atelier-lyon/Epiled_slaves/Small/README.md

# Small Board
## By Florian "FloRide" Reimat

## About
This is the Small board

## Images:
### [Schematic](Export/Schematics.pdf):


### [PCB](Export/PCB.pdf):
| Front | Bottom |
:------:|:-------:
|| |

### 3D:
| Simple | Detailled |
:------:|:-------:
|| |

## Others:
- [Interactive BOM](Export/ibom/ibom.html) (Download it and use it)
