atelier-lyon/Epiled_slaves/Small_Wall/Export/Schematic.pdf

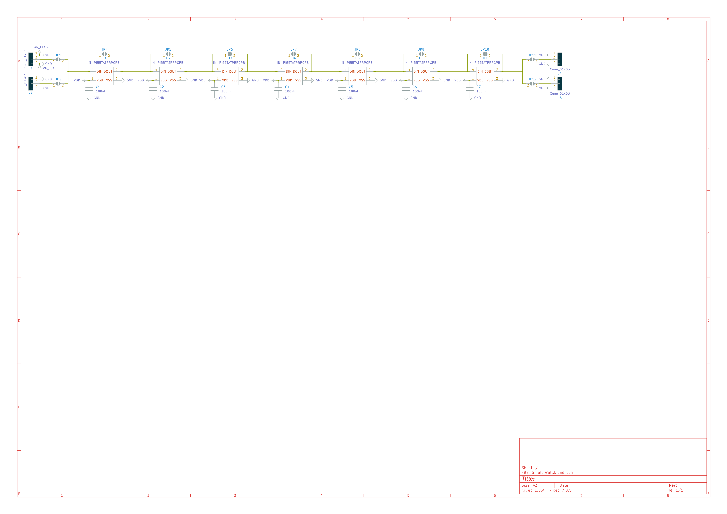
[picture p1: page 1]
