atelier-lyon/Epiled_slaves/Small_Wall/View/small_wall_v1.0.step

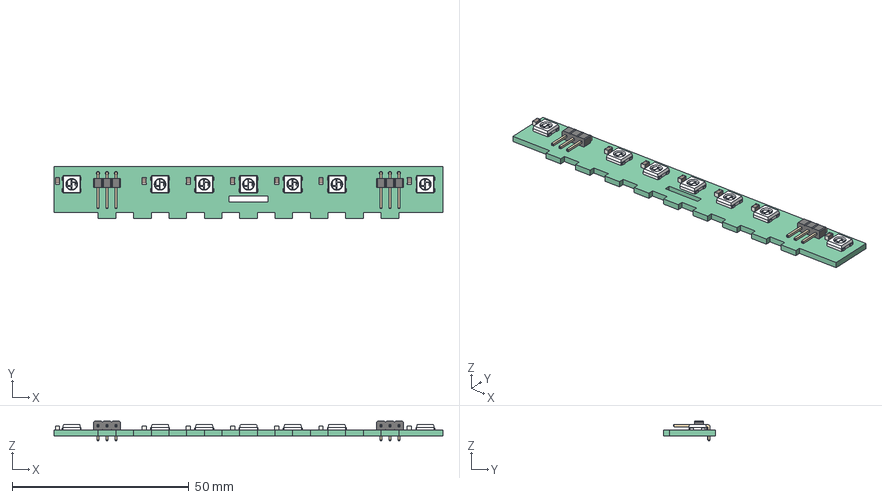
[picture p2: CAD file, 2023-07-18]
Small_Wall/View/small_wall_v1.0.step
110.0 x 14.6 x 5.54 mm
Local_CS_955f
Pcb_955f
J1_PinHeader_1x03_P254mm_Horizontal_86b41215f255
C6_C_0805_2012Metric_c65d50394145
U2_IN-PI55TATPRPGPB_b85f727c27e0
C4_C_0805_2012Metric_1086d08a19b9
U5_IN-PI55TATPRPGPB_a745e96a4803
U6_IN-PI55TATPRPGPB_b1dd87a4917c
C2_C_0805_2012Metric_acea1357e9b1
C7_C_0805_2012Metric_d1ab99c13446
C3_C_0805_2012Metric_30713c1e22a0
U1_IN-PI55TATPRPGPB_baa3a1cbfda9
J4_PinHeader_1x03_P254mm_Horizontal_40c13ec2b1c1
U4_IN-PI55TATPRPGPB_b795d5d795ae
U3_IN-PI55TATPRPGPB_56d7a105f291
U7_IN-PI55TATPRPGPB_ceba1dbc2faf
C1_C_0805_2012Metric_a1f97324ab0b
C5_C_0805_2012Metric_711e44d1b90e
