atelier-lyon/Epiled_slaves/(list of files, cad)

Other CAD files:
Small/DXF/Small-B_Silkscreen.dxf
Small/DXF/Small-F_Silkscreen.dxf
Small_Wall/DXF/Small_Wall-B_Silkscreen.dxf
Small_Wall/DXF/Small_Wall-F_Silkscreen.dxf
