atelier-lyon/Epiled_slaves/Small/Export/Schematic.pdf

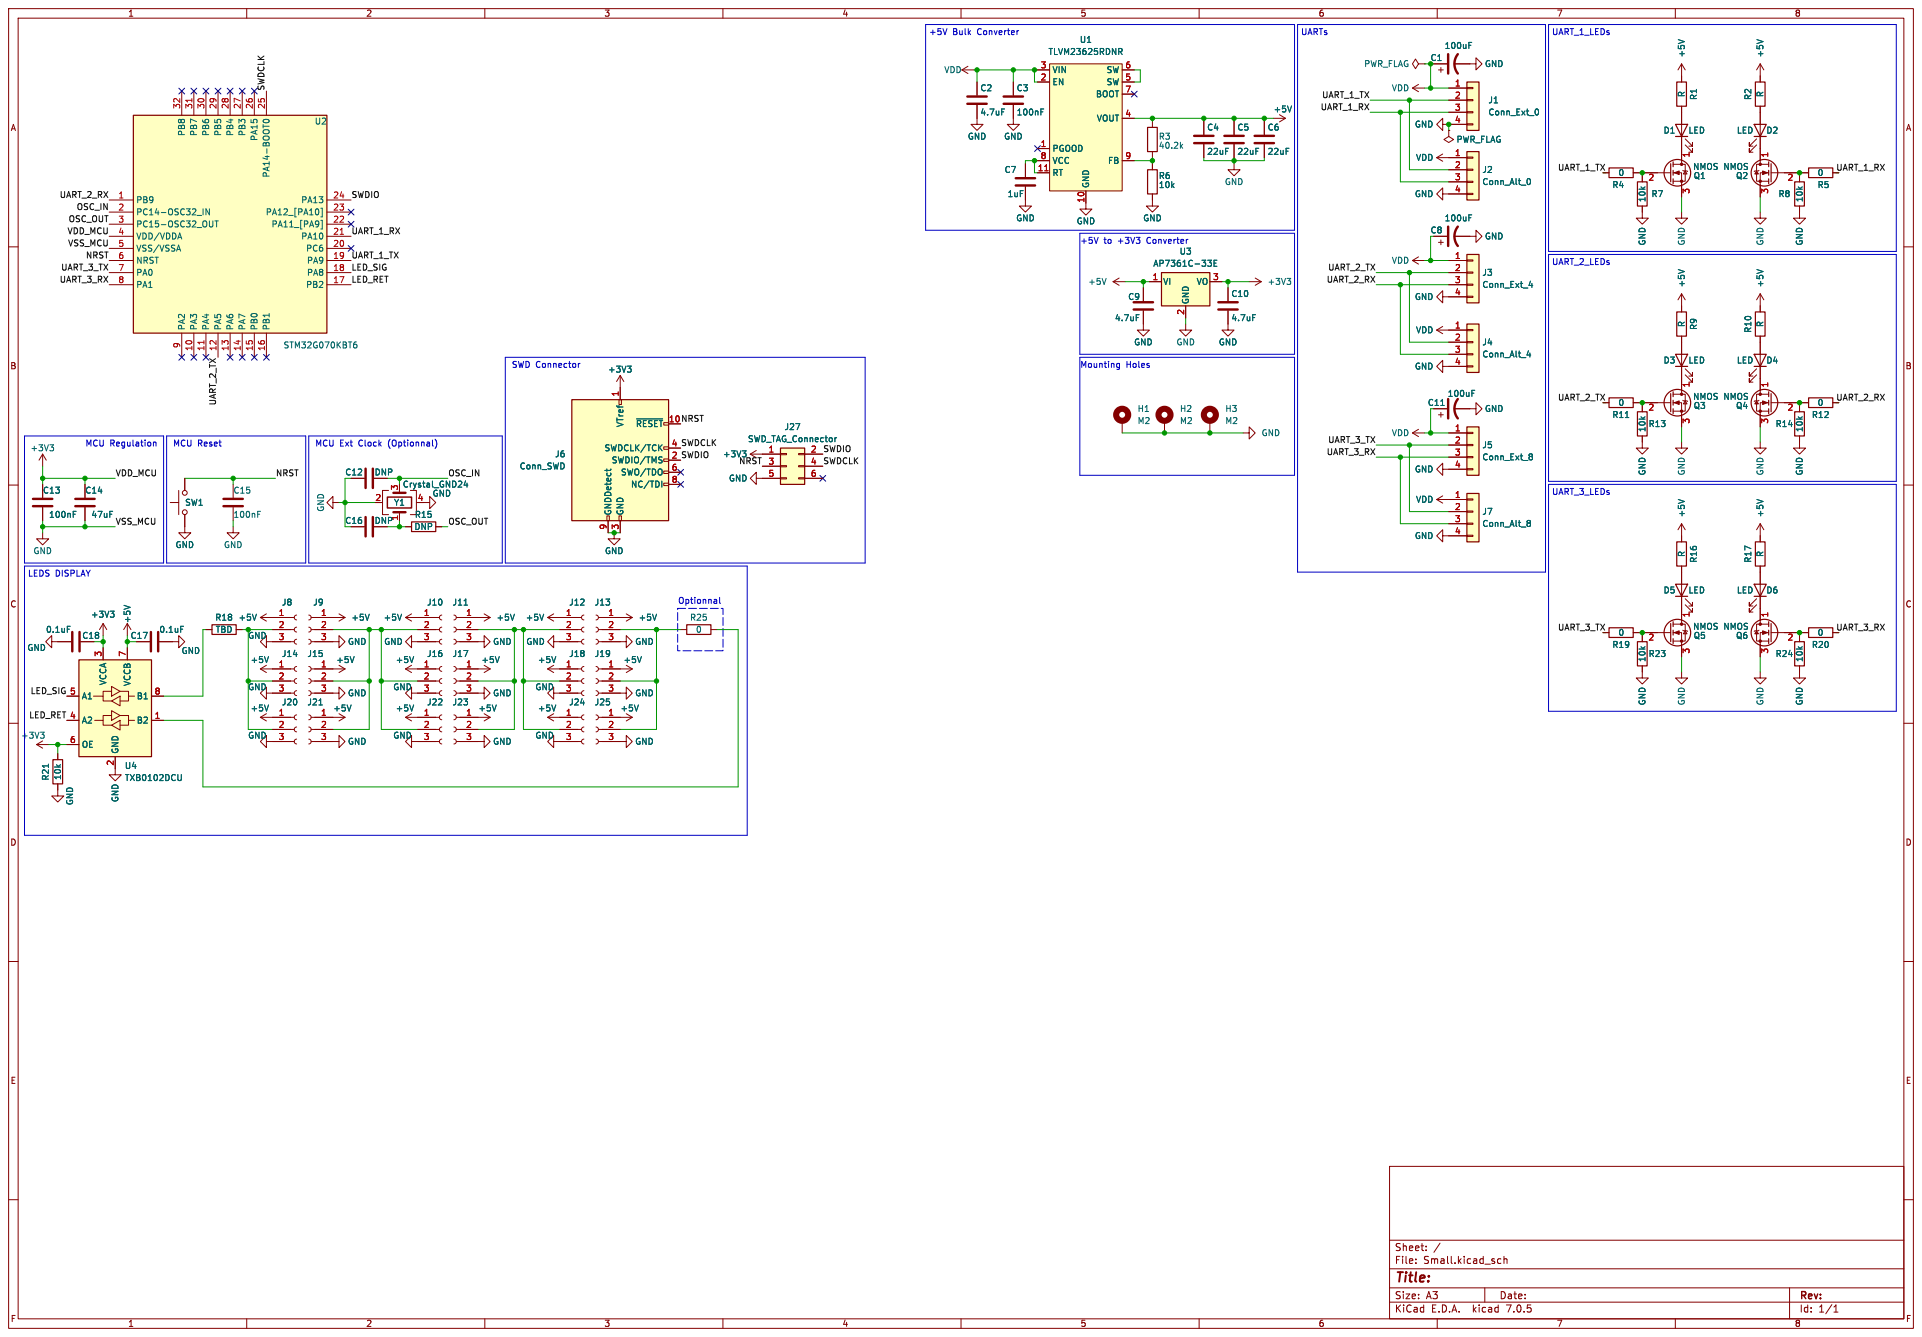
[picture p3: page 1]

3 SWDCLK/TCK 4 SWO/TDO 6 NC/TDI 8 GNDDetect 9 +3V3 GND GND

3 SWDCLK/TCK 4 SWO/TDO 6 NC/TDI 8 GNDDetect 9

Id: 1/1 Title: File: Small.kicad_sch Sheet: /
