atelier-lyon/Epiled_slaves/Small_Wall/Export/PCB.pdf

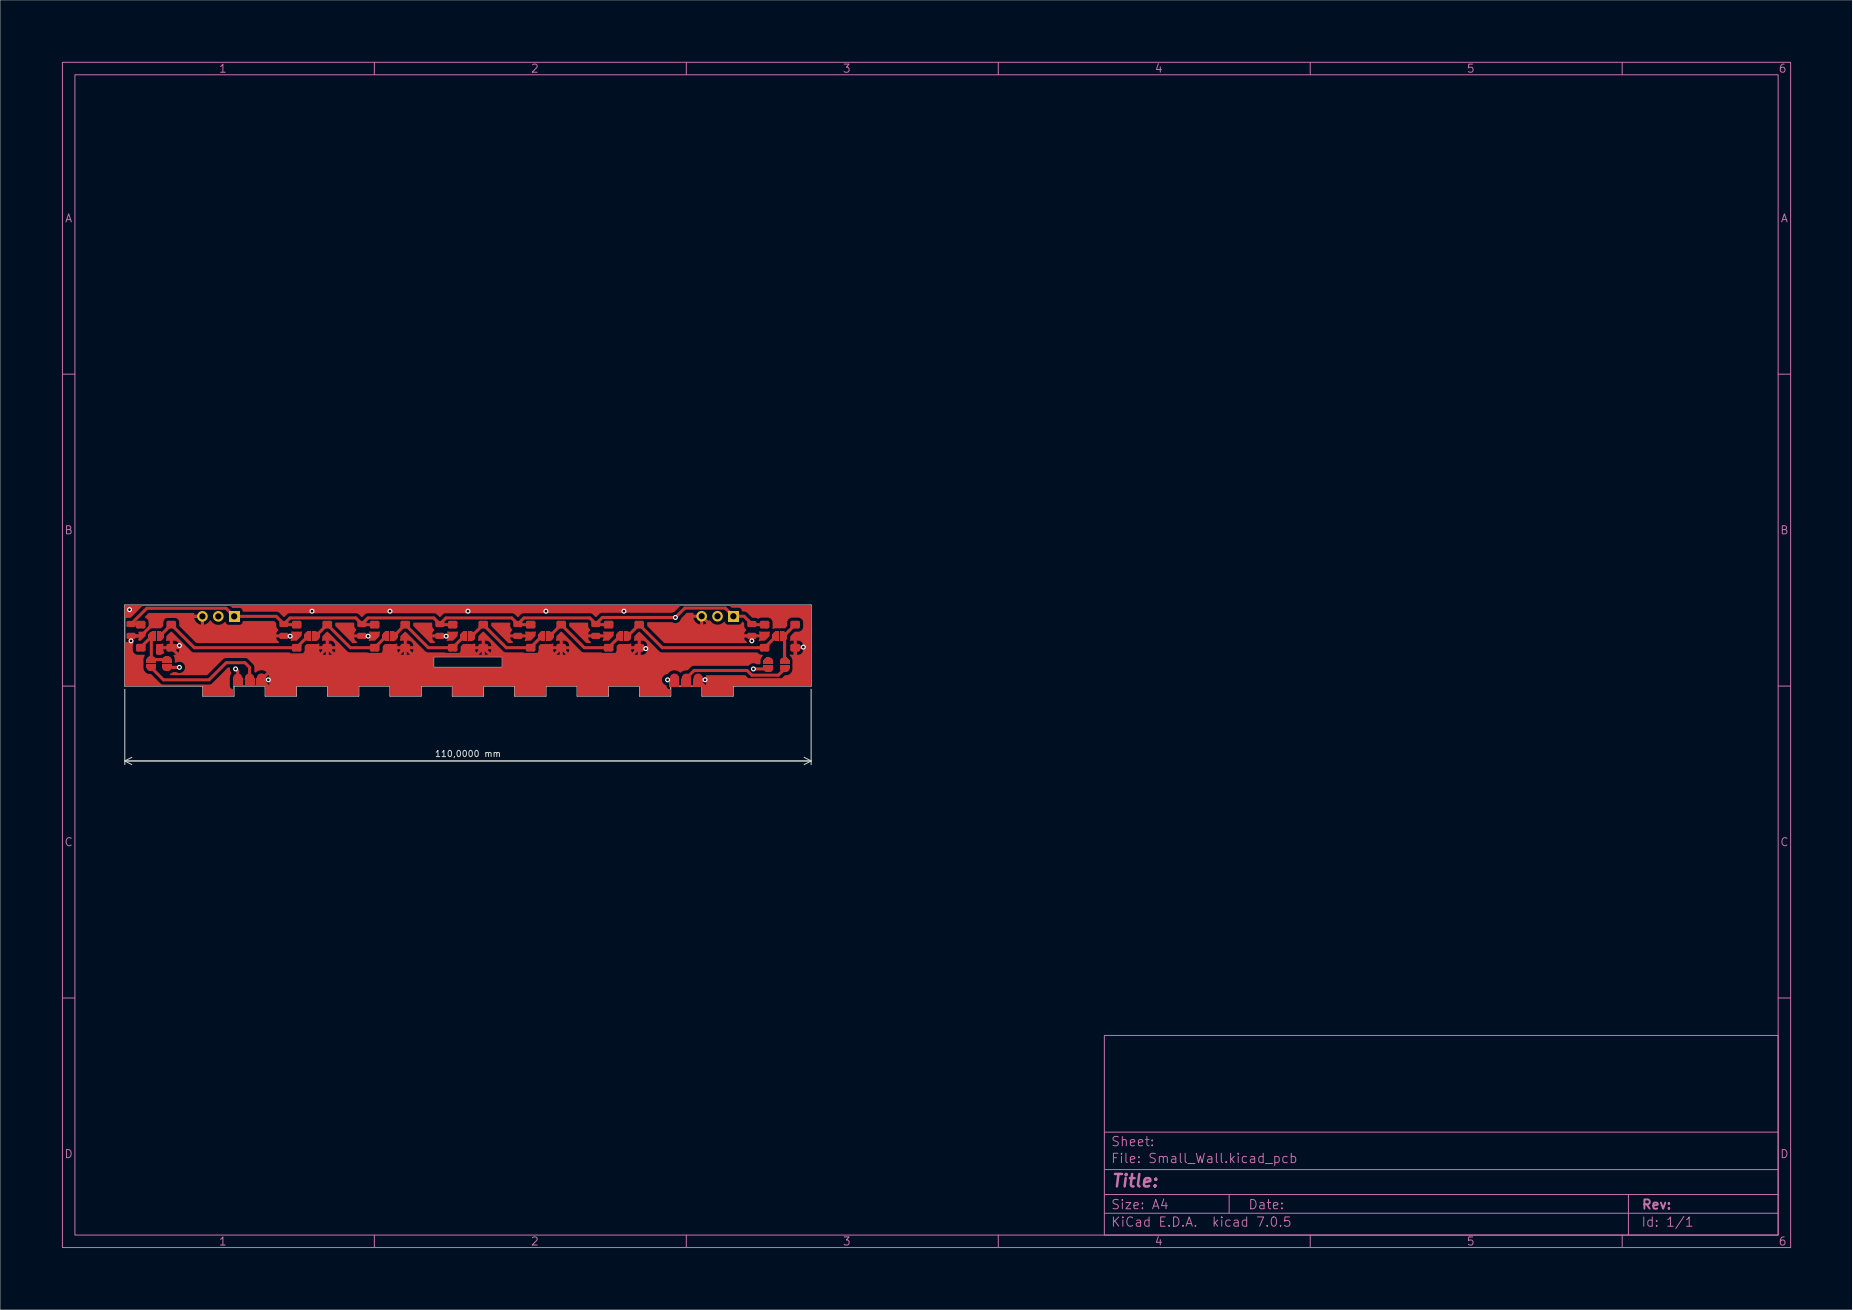
[picture p4: page 1]

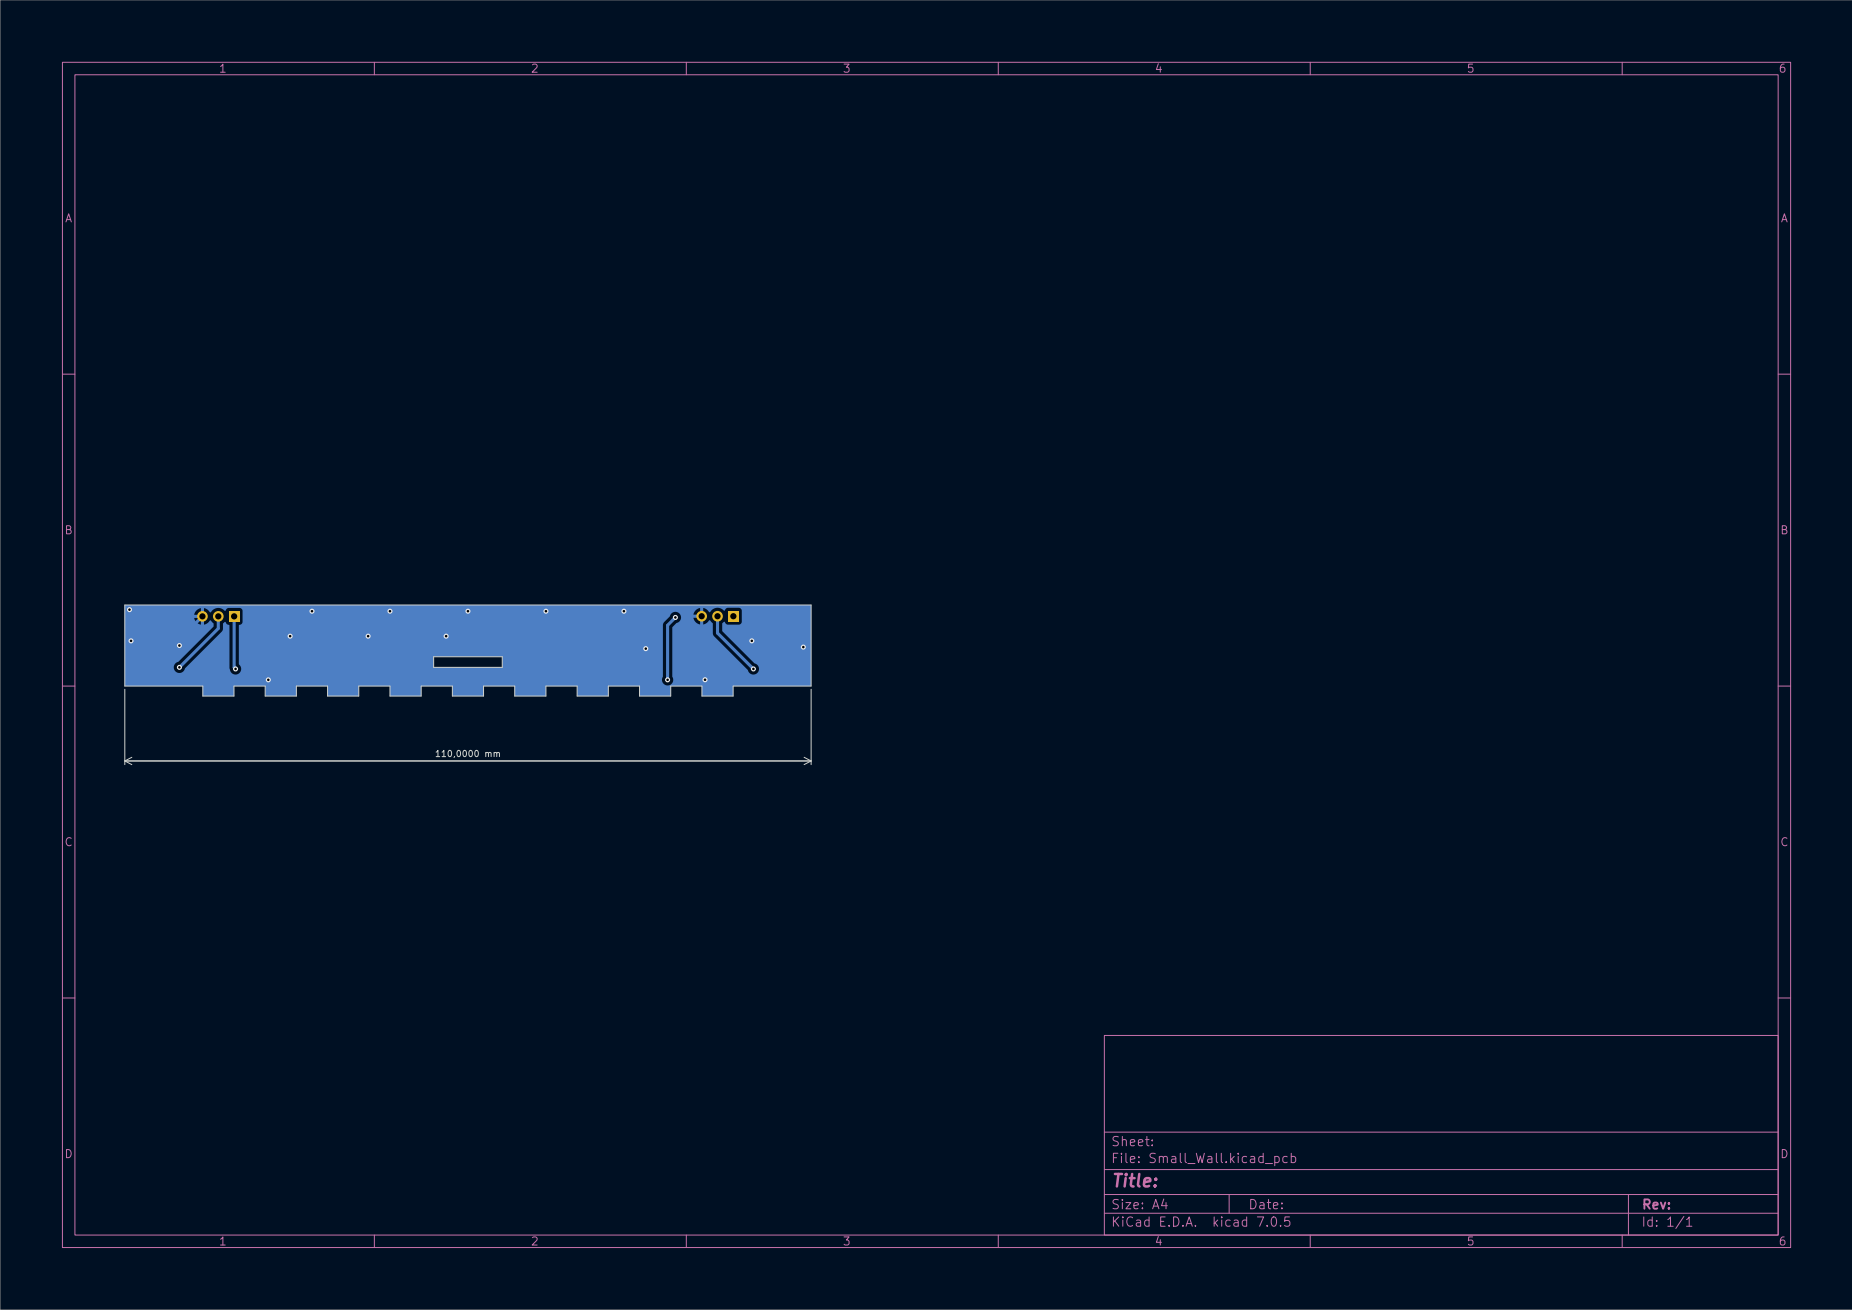
[picture p5: page 2]

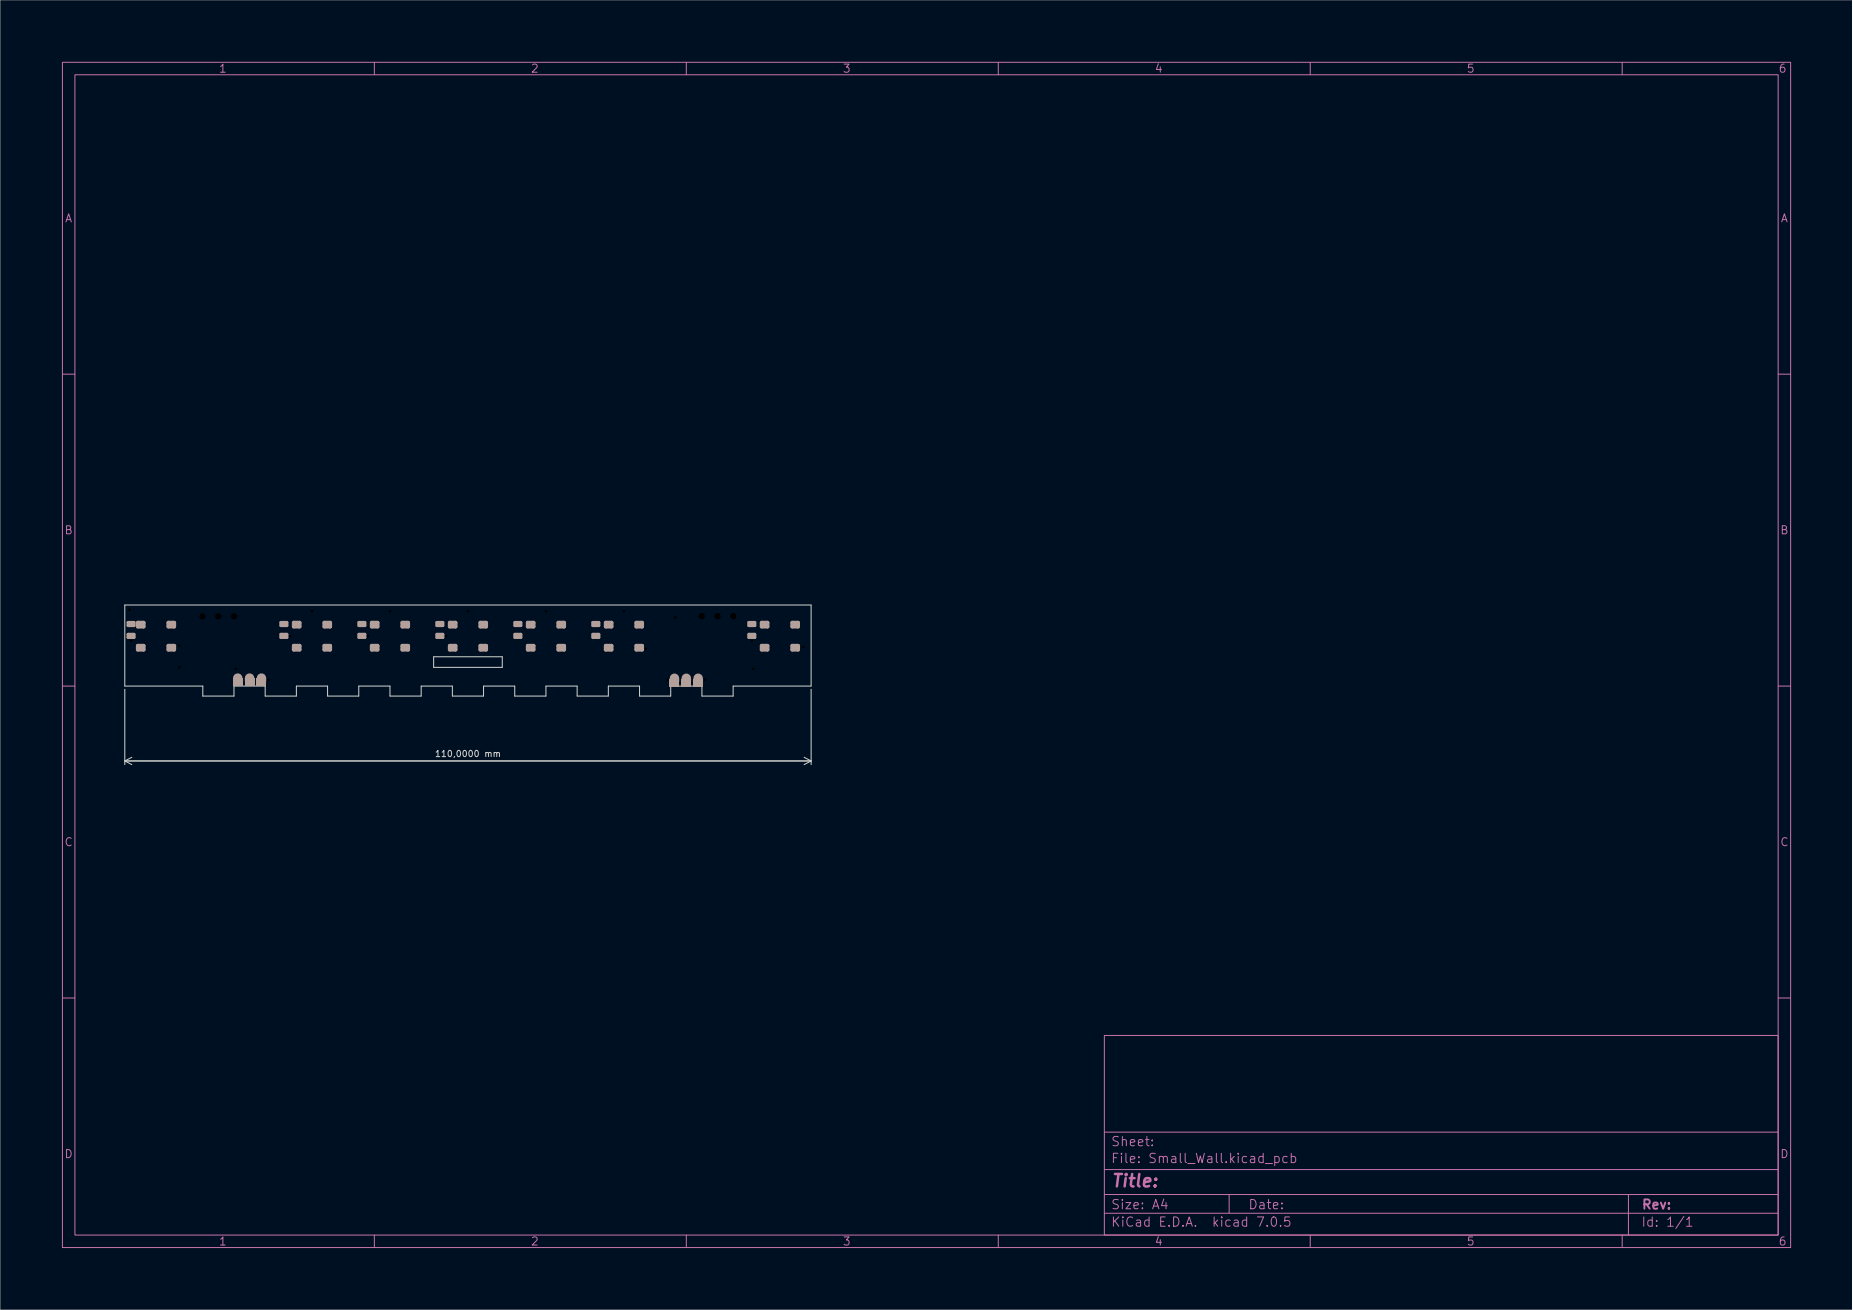
[picture p6: page 3]

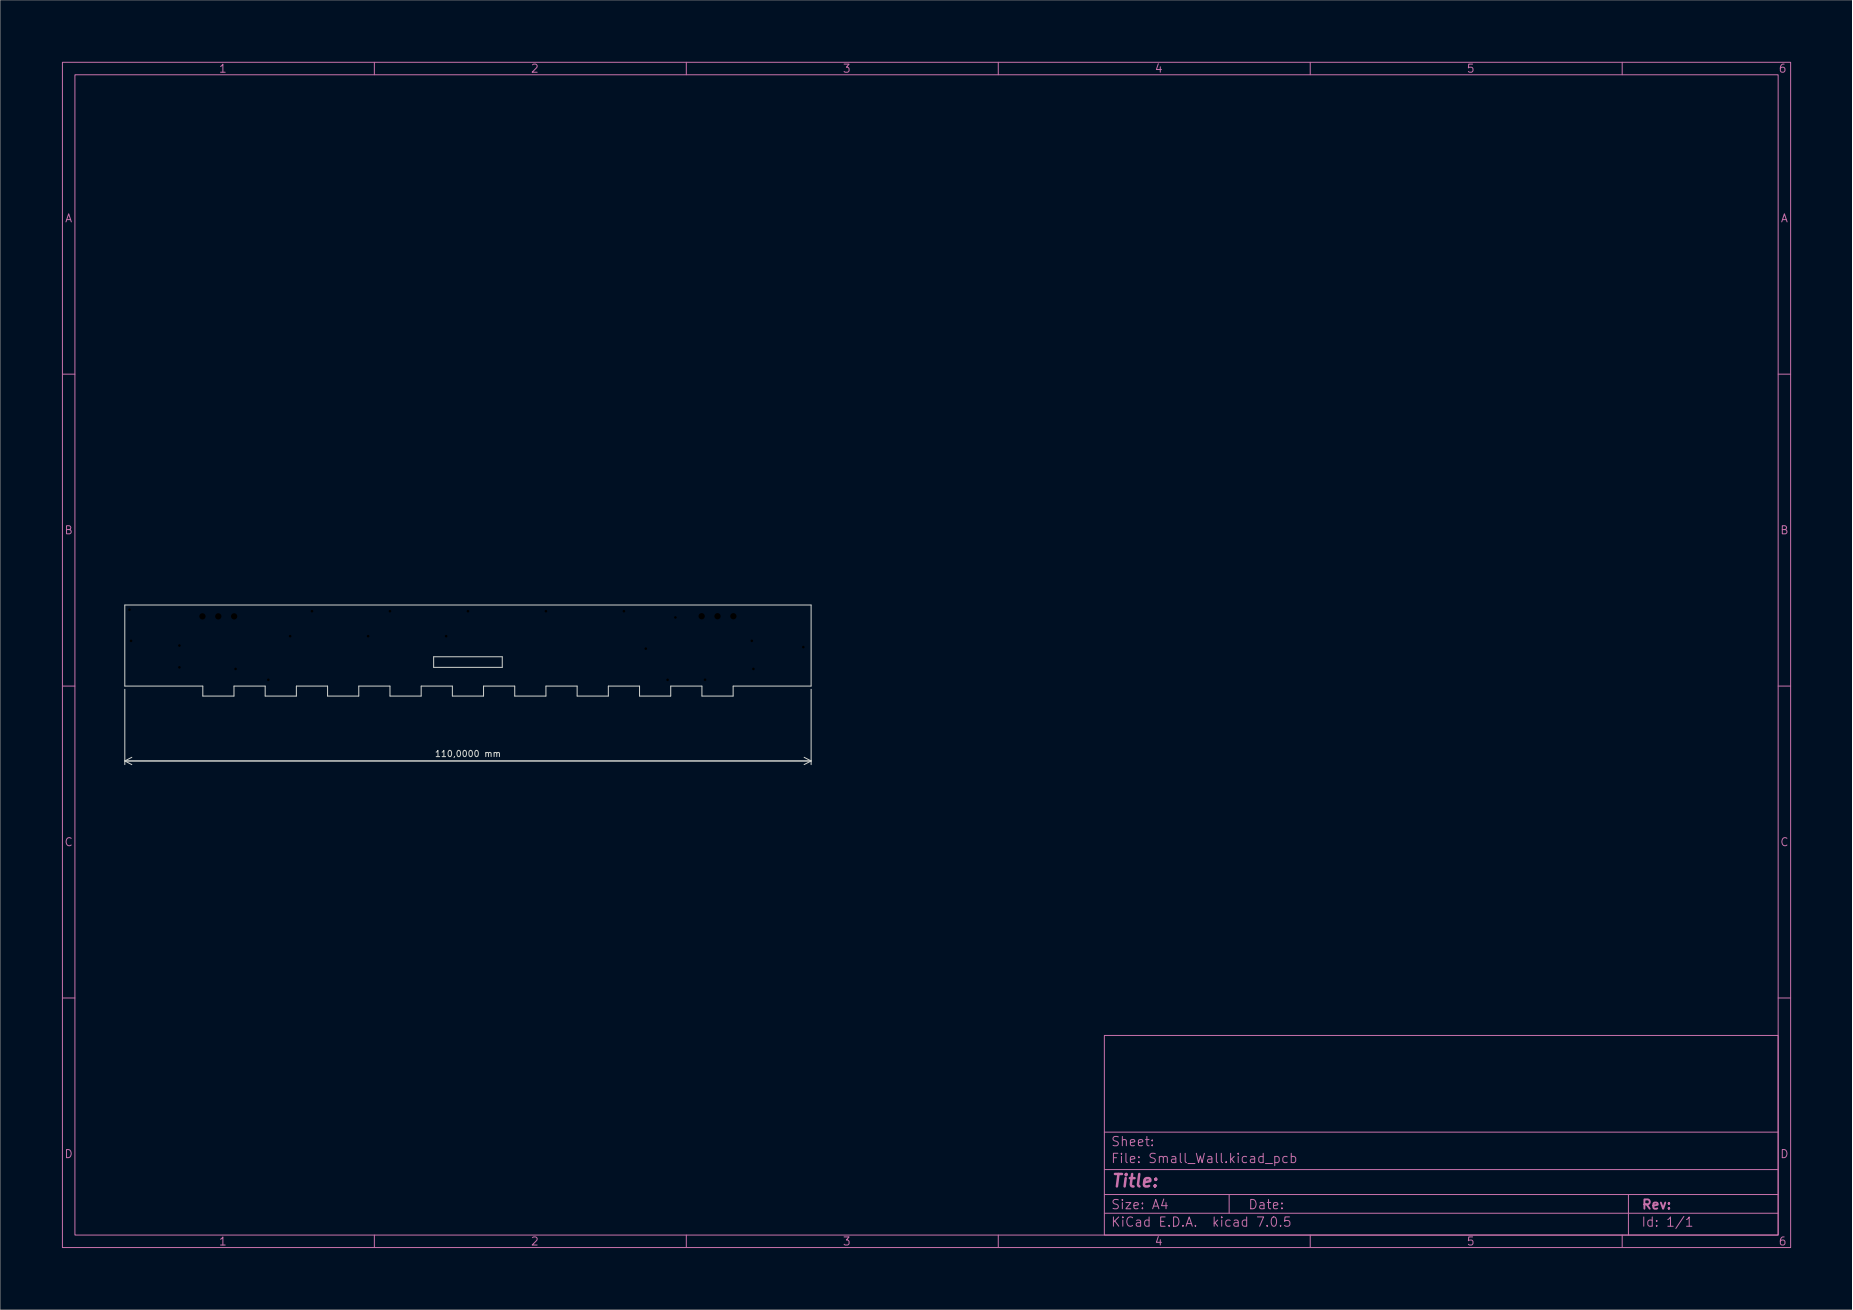
[picture p7: page 4]

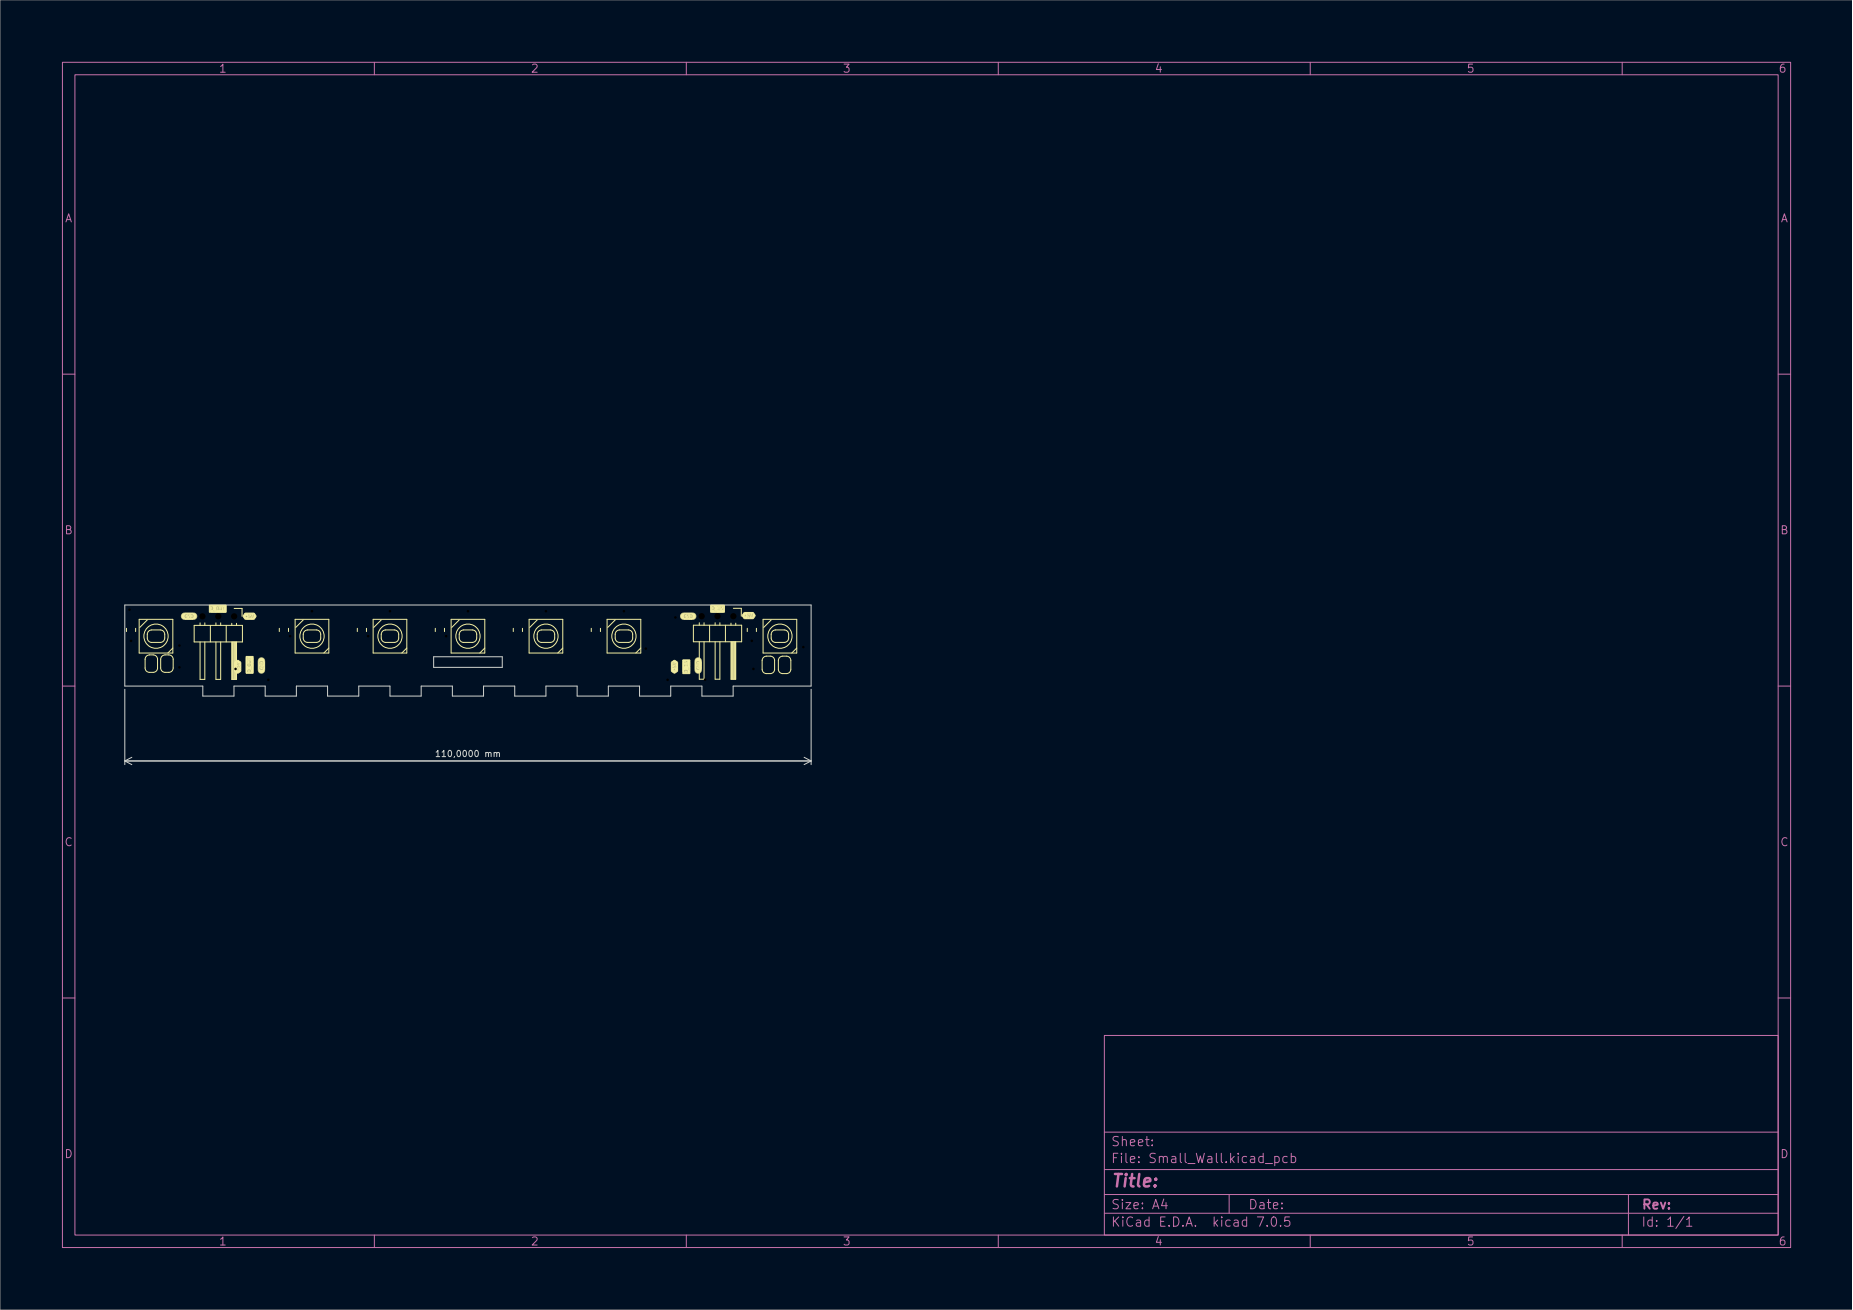
[picture p8: page 5]

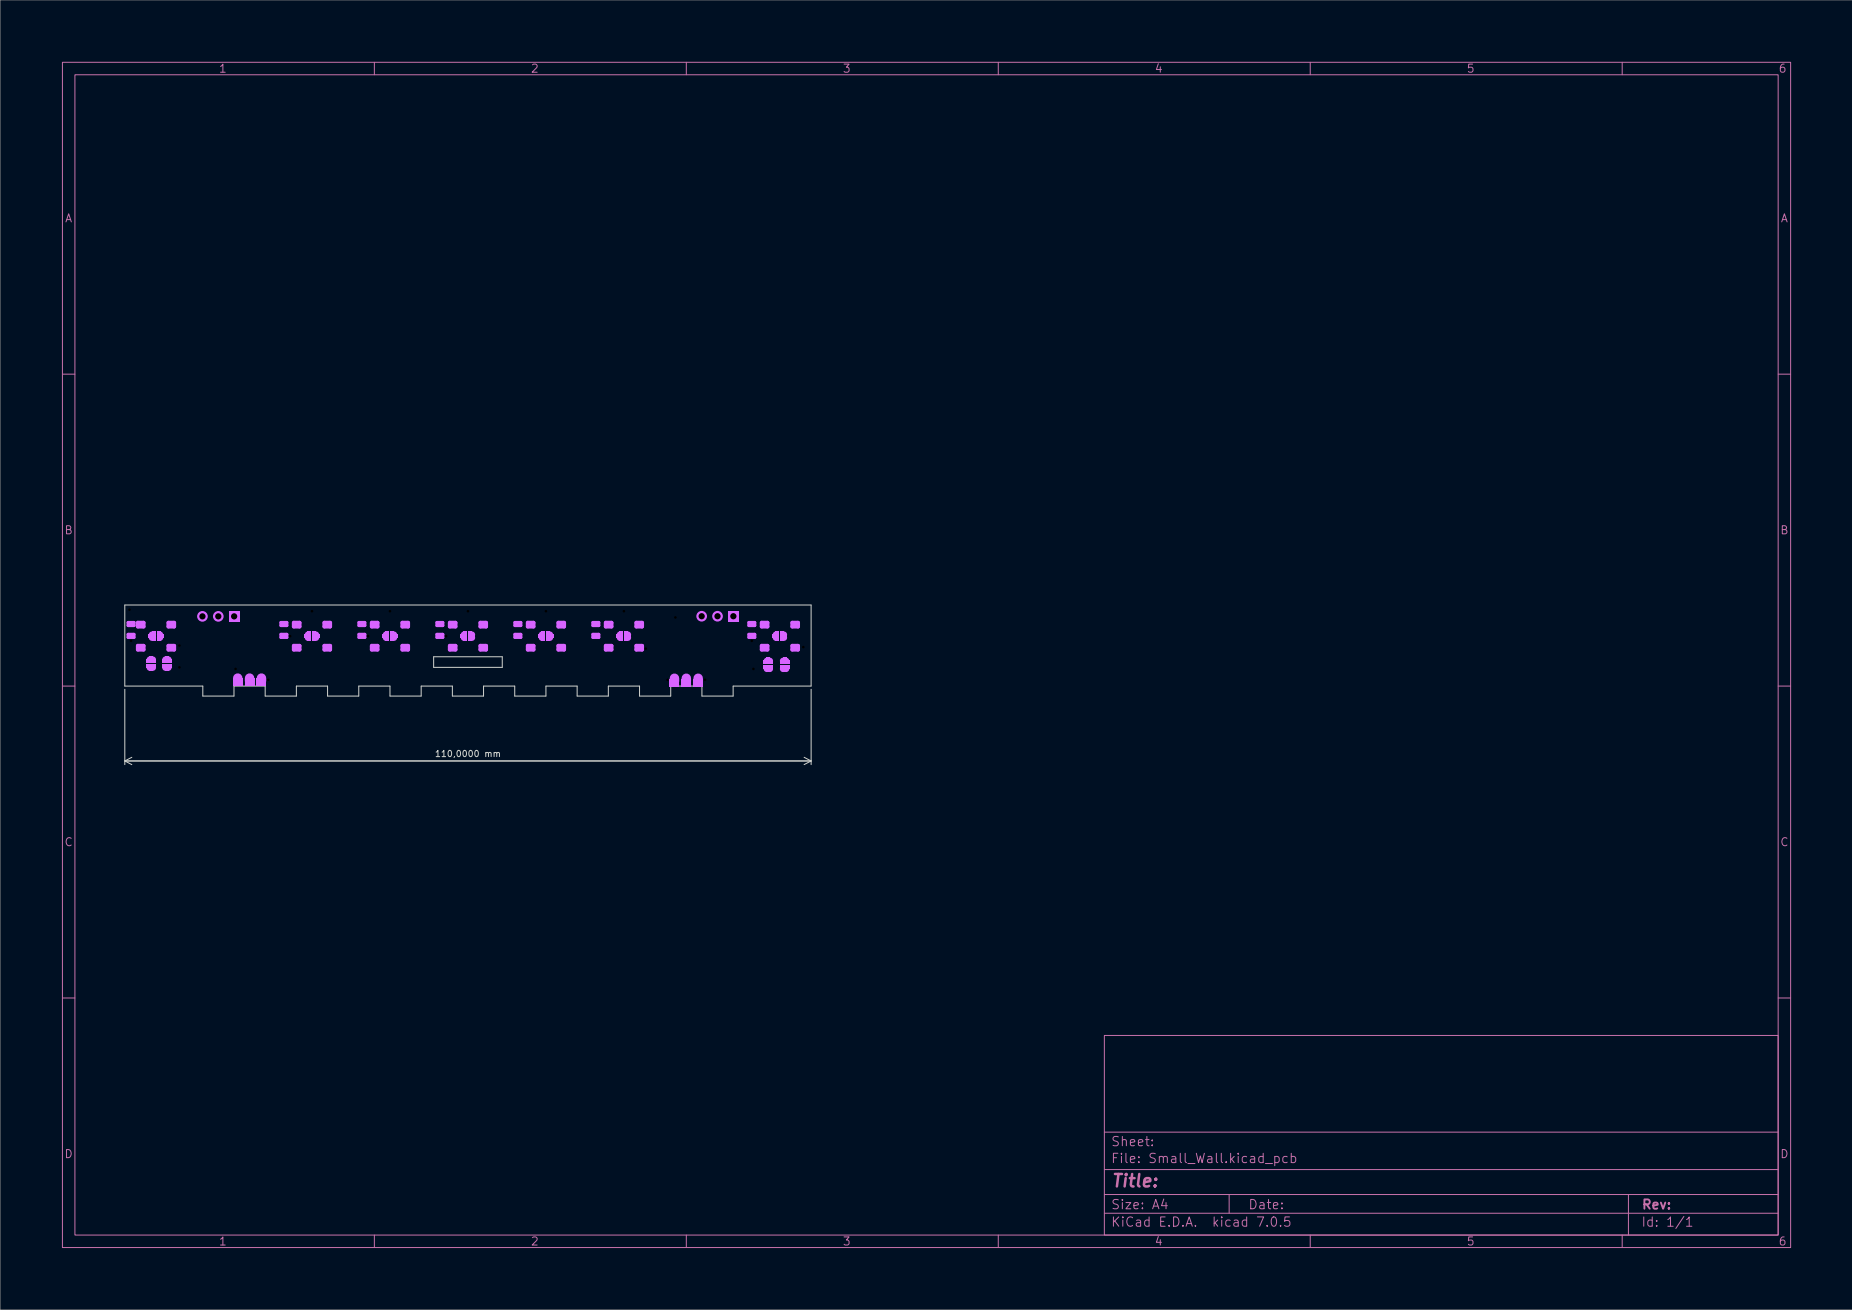
[picture p9: page 7]

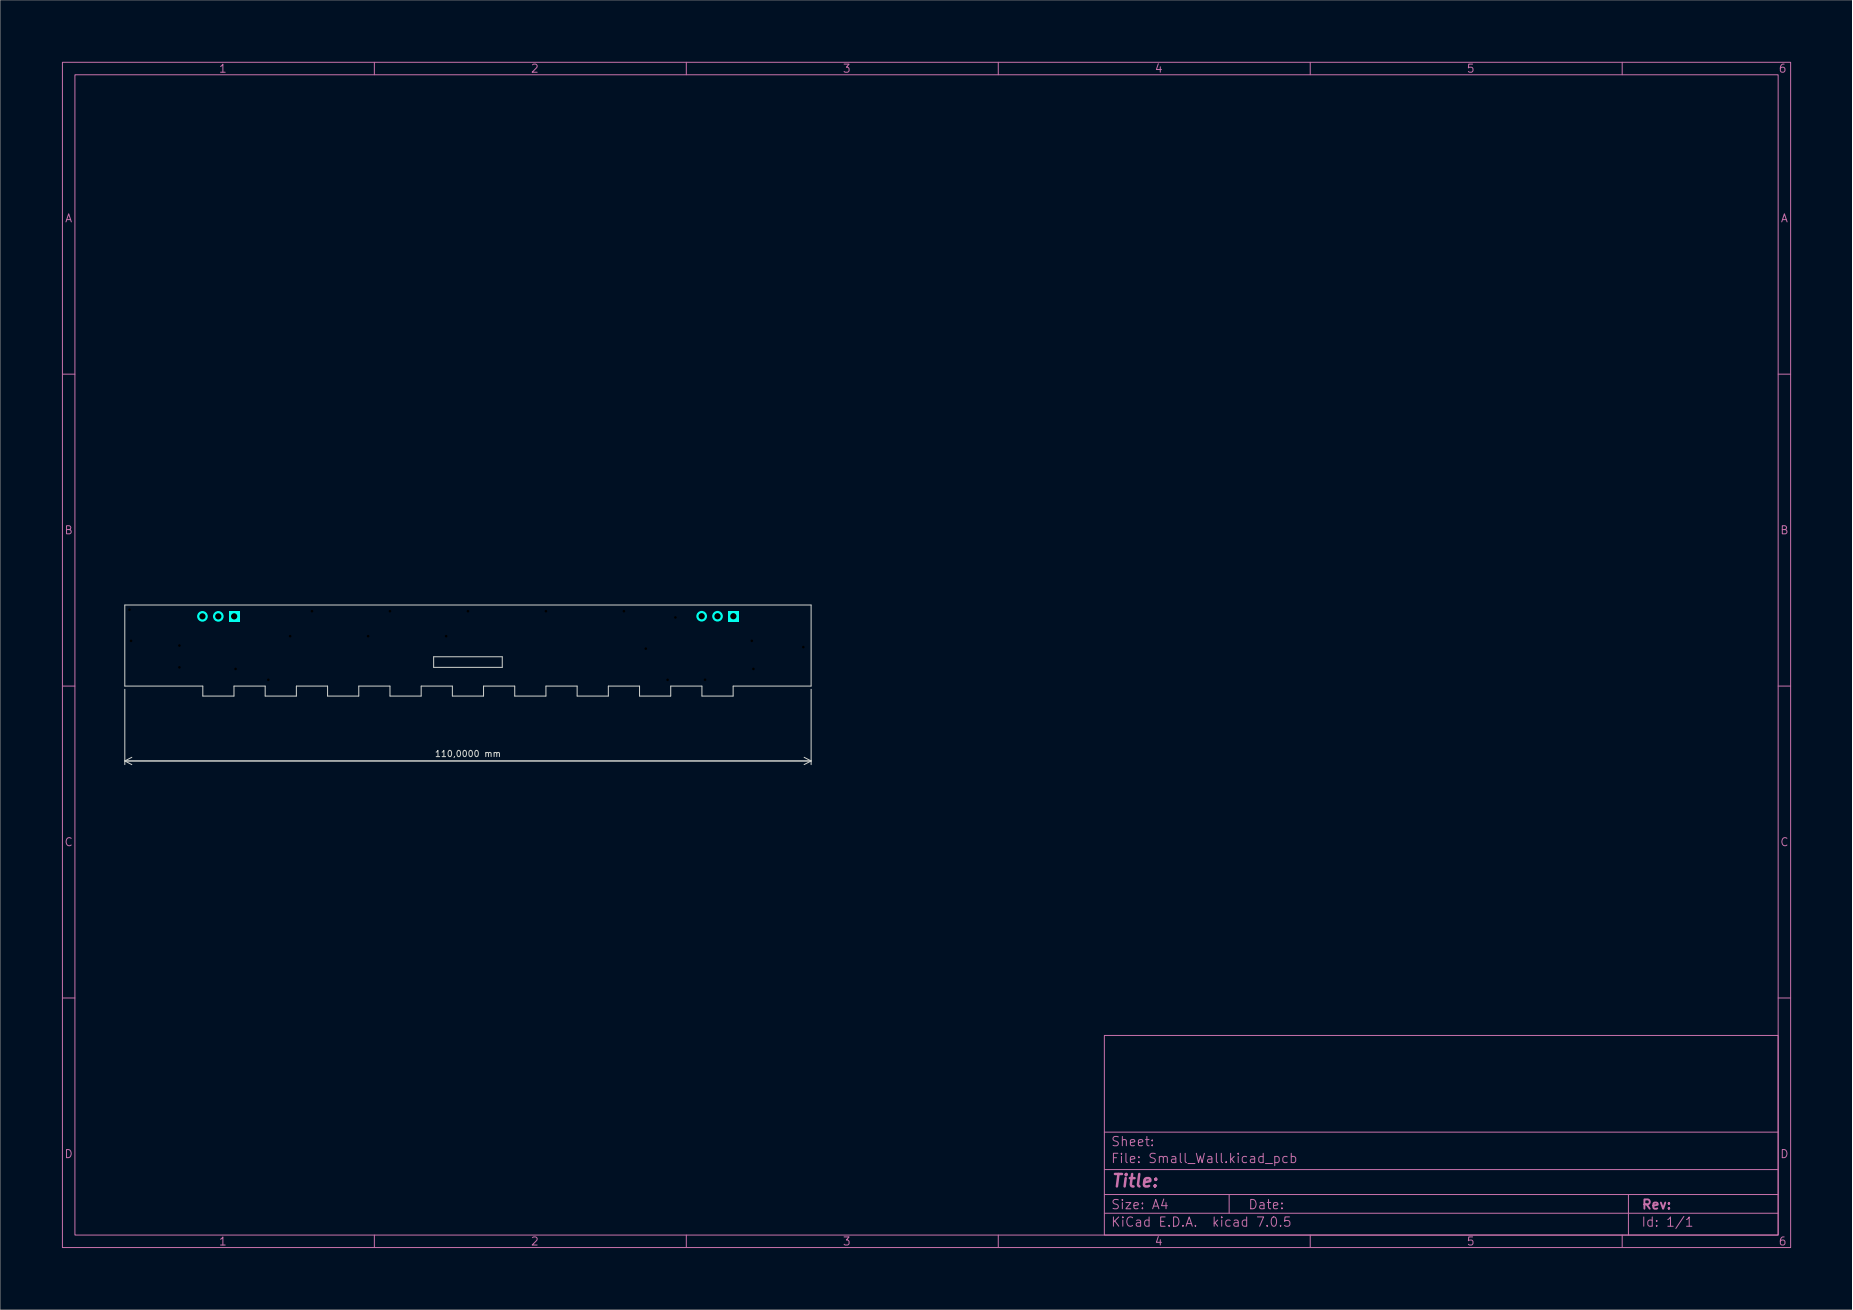
[picture p10: page 8]
