atelier-lyon/Epiled_slaves/Small_Wall/Small_Wall.kicad_pcb

## KiCad design Small_Wall/Small_Wall.kicad_pcb (2023-11-13)

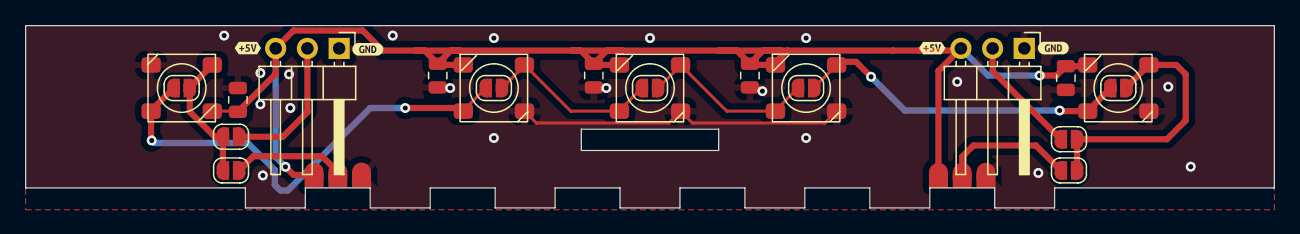
[picture p20: board Small_Wall.kicad_pcb from above]

Board: 2 copper layers, 100.0 x 14.6 mm, 27 parts (0 on the bottom side), 12 nets.

Parts:
C1, C2, C3, C4, C5: 100nF; C_0805_2012Metric
J1, J3: Conn_01x03; PinHeader_1x03_P2.54mm_Horizontal
J2, J4: Conn_01x03; SolderWirePad_1x03_Corner_SMD
JP1, JP2, JP3, JP4, JP5, JP6, JP7, JP8, JP9: SolderJumper_2_Open; SolderJumper-2_P1.3mm_Open_RoundedPad1.0x1.5mm
U1, U2, U3, U4, U5: IN-PI55TATPRPGPB
kibuzzard-64B1960B, kibuzzard-64B1960B#2: G***; kibuzzard-64B1960B
kibuzzard-64B19658, kibuzzard-64B19658#2: G***; kibuzzard-64B19658

Connections:
GND: C1.2, C2.2, C3.2, C4.2, C5.2, J1.1, J2.1, J3.1, J4.1, U1.3 (VSS), U2.3 (VSS), U3.3 (VSS), U4.3 (VSS), U5.3 (VSS)
unnamed: J1.2, JP1.1 (A)
unnamed: J2.2, JP2.1 (A)
unnamed: J3.2, JP8.1 (A)
unnamed: J4.2, JP9.1 (A)
unnamed: JP1.2 (B), JP2.2 (B), JP3.1 (A), U1.4 (DIN)
unnamed: JP3.2 (B), JP4.1 (A), U1.2 (DOUT), U2.4 (DIN)
unnamed: JP4.2 (B), JP5.1 (A), U2.2 (DOUT), U3.4 (DIN)
unnamed: JP5.2 (B), JP6.1 (A), U3.2 (DOUT), U4.4 (DIN)
unnamed: JP6.2 (B), JP7.1 (A), U4.2 (DOUT), U5.4 (DIN)
unnamed: JP7.2 (B), JP8.2 (B), JP9.2 (B), U5.2 (DOUT)
VDD: C1.1, C2.1, C3.1, C4.1, C5.1, J1.3, J2.3, J3.3, J4.3, U1.1 (VDD), U2.1 (VDD), U3.1 (VDD), U4.1 (VDD), U5.1 (VDD)
