atelier-lyon/Epiled_slaves/Small/Small.kicad_pcb

## KiCad design Small/Small.kicad_pcb (2023-11-13)

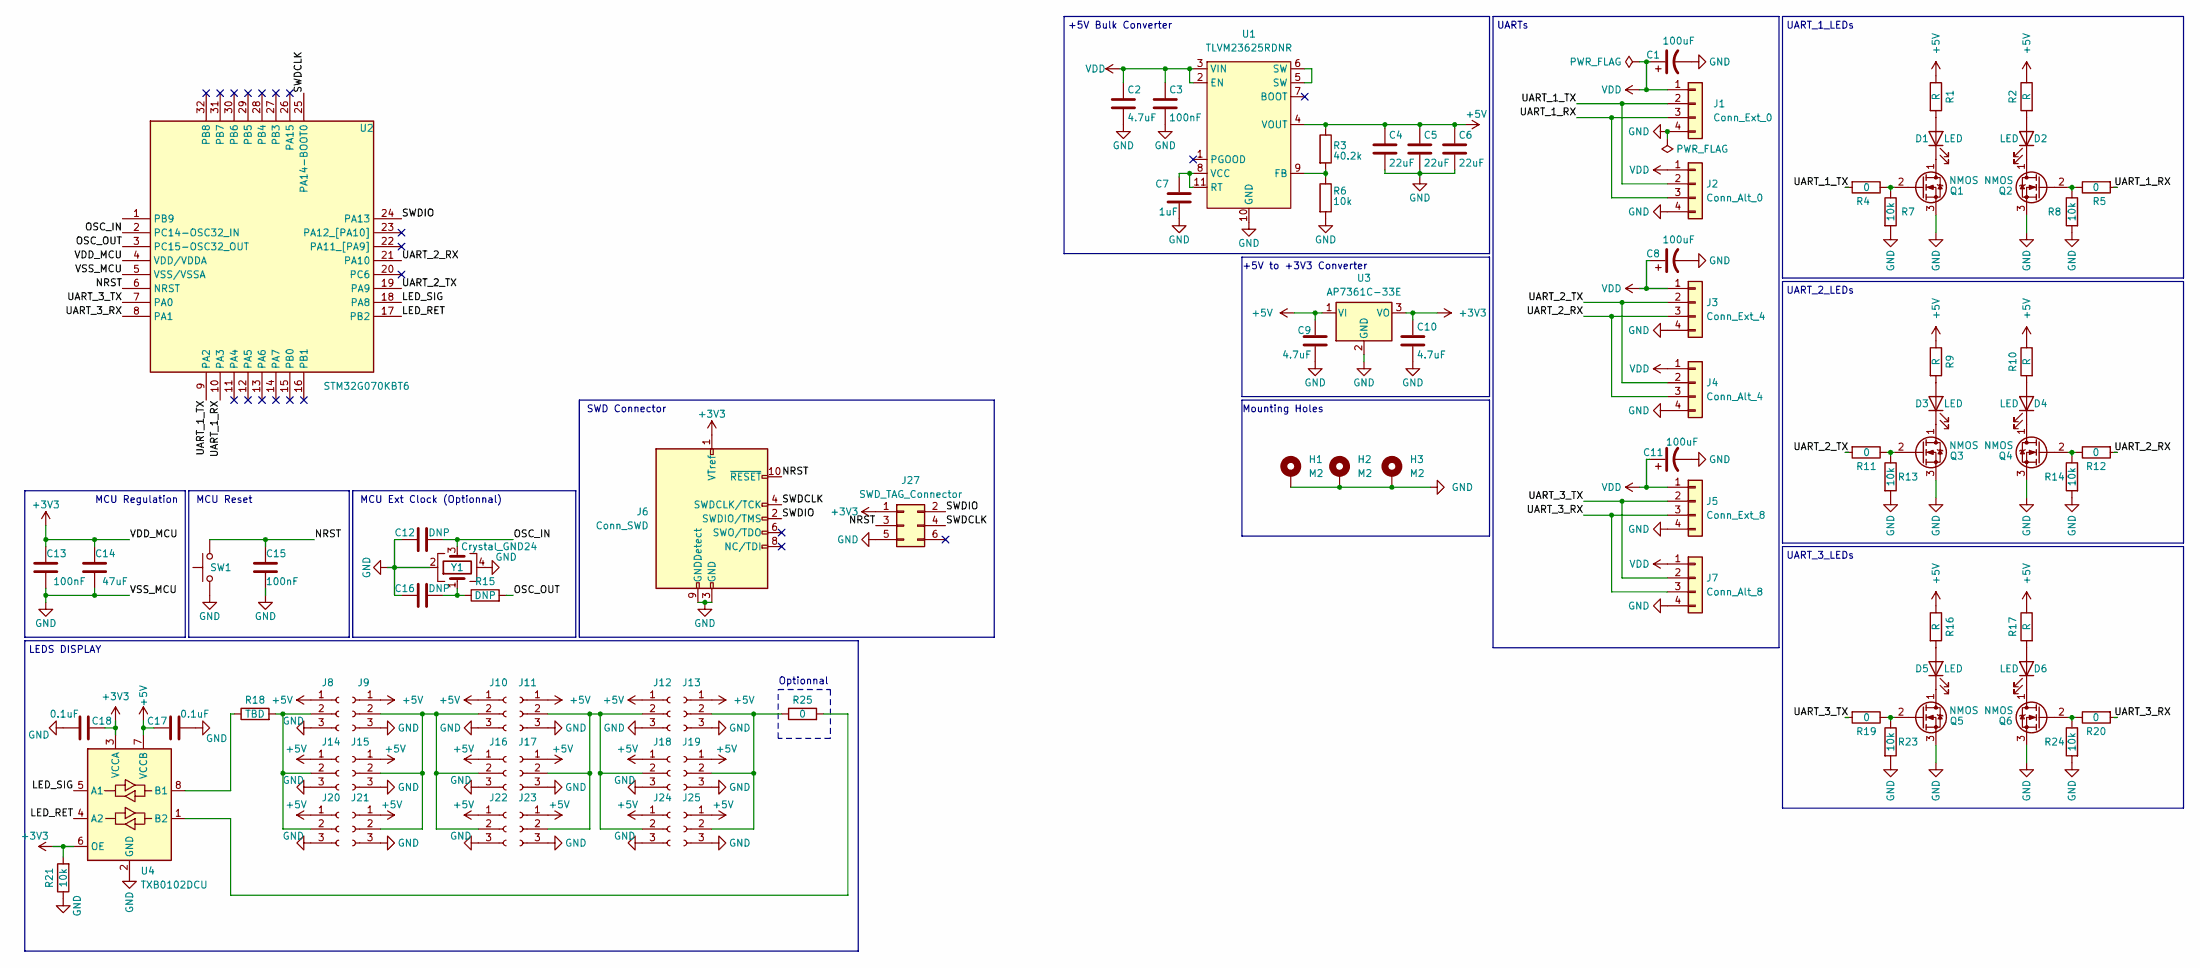
[picture p21: schematic Small.kicad_sch]

Parts:
C1, C8, C11: 100uF; CP_Radial_D8.0mm_P3.50mm
C2, C9, C10: 4.7uF; C_0805_2012Metric_Pad1.18x1.45mm_HandSolder
C3, C13, C15: 100nF; C_0805_2012Metric_Pad1.18x1.45mm_HandSolder
C4, C5, C6: 22uF; C_0805_2012Metric_Pad1.18x1.45mm_HandSolder
C7: 1uF; C_0805_2012Metric_Pad1.18x1.45mm_HandSolder
C12, C16: DNP; C_0805_2012Metric_Pad1.18x1.45mm_HandSolder
C14: 47uF; C_0805_2012Metric_Pad1.18x1.45mm_HandSolder
C17, C18: 0.1uF; C_0805_2012Metric_Pad1.18x1.45mm_HandSolder
D1, D2, D3, D4, D5, D6: LED; LED_0805_2012Metric_Pad1.15x1.40mm_HandSolder
H1, H2, H3: M2; MountingHole_2.7mm_M2.5_DIN965_Pad
J1: Conn_Ext_0; QFN_4-M0G
J2: Conn_Alt_0; JST_XH_B4B-XH-A_1x04_P2.50mm_Vertical
J3: Conn_Ext_4; QFN_4-M0G
J4: Conn_Alt_4; JST_XH_B4B-XH-A_1x04_P2.50mm_Vertical
J5: Conn_Ext_8; QFN_4-M0G
J6: Conn_SWD; PinHeader_2x05_P1.27mm_Vertical_SMD
J7: Conn_Alt_8; JST_XH_B4B-XH-A_1x04_P2.50mm_Vertical
J8, J9, J10, J11, J12, J13: Conn_01x03_Female; PinSocket_1x03_P2.54mm_Vertical
J14, J15, J16, J17, J18, J19: Conn_01x03_Female; JST_XH_B3B-XH-A_1x03_P2.50mm_Vertical
J20, J21, J22, J23, J24, J25: Conn_01x03_Female; SolderWirePad_1x03_Corner_SMD
J27: SWD_TAG_Connector; Tag-Connect_TC2030-IDC-NL_2x03_P1.27mm_Vertical
Q1, Q2, Q3, Q4, Q5, Q6: NMOS; SOT-23_Handsoldering
R1, R2, R9, R10, R16, R17: R; R_0805_2012Metric_Pad1.20x1.40mm_HandSolder
R3: 40.2k; R_0805_2012Metric_Pad1.20x1.40mm_HandSolder
R4, R5, R11, R12, R19, R20, R25: 0; R_0805_2012Metric_Pad1.20x1.40mm_HandSolder
R6, R7, R8, R13, R14, R21, R23, R24: 10k; R_0805_2012Metric_Pad1.20x1.40mm_HandSolder
R15: DNP; R_0805_2012Metric_Pad1.20x1.40mm_HandSolder
R18: TBD; R_0805_2012Metric_Pad1.20x1.40mm_HandSolder
SW1: SW_Push; SW_Push_1P1T_NO_CK_KSC7xxJ
U1: TLVM23625RDNR; QFN-FCMOD11_RDN_TEX
U2: STM32G070KBT6; LQFP-32_7x7mm_P0.8mm
U3: AP7361C-33E; SOT-223-3_TabPin2
U4: TXB0102DCU; VSSOP-8_2.4x2.1mm_P0.5mm
Y1: Crystal_GND24; Crystal_SMD_2016-4Pin_2.0x1.6mm

Connections:
+3V3: C10.1, C13.1, C14.1, C18.1, J6.1 (VTref), J27.1, R21.2, U2.4 (VDD/VDDA), U3.3 (VO), U4.3 (VCCA), U4.6 (OE)
+5V: C4.1, C5.1, C6.1, C9.1, C17.1, J8.1, J9.1, J10.1, J11.1, J12.1, J13.1, J14.1, J15.1, J16.1, J17.1, J18.1, J19.1, J20.1, J21.1, J22.1, J23.1, J24.1, J25.1, R1.1, R2.1, R3.1, R9.1, R10.1, R16.1, R17.1, U1.4 (VOUT), U3.1 (VI), U4.7 (VCCB)
/LED_RET: U2.17 (PB2), U4.4 (A2)
/LED_SIG: U2.18 (PA8), U4.5 (A1)
/NRST: C15.1, J6.10 (~RESET), J27.3, SW1.2, U2.6 (NRST)
/OSC_IN: C12.2, U2.2 (PC14-OSC32_IN), Y1.3
/OSC_OUT: R15.2, U2.3 (PC15-OSC32_OUT)
/SWDCLK: J6.4 (SWDCLK/TCK), J27.4, U2.25 (PA14-BOOT0)
/SWDIO: J6.2 (SWDIO/TMS), J27.2, U2.24 (PA13)
/UART_1_RX: J1.3, J2.3, R5.2, U2.10 (PA3)
/UART_1_TX: J1.2, J2.2, R4.2, U2.9 (PA2)
/UART_2_RX: J3.3, J4.3, R12.2, U2.21 (PA10)
/UART_2_TX: J3.2, J4.2, R11.2, U2.19 (PA9)
/UART_3_RX: J5.3, J7.3, R20.2, U2.8 (PA1)
/UART_3_TX: J5.2, J7.2, R19.2, U2.7 (PA0)
GND: C1.2, C2.2, C3.2, C4.2, C5.2, C6.2, C7.2, C8.2, C9.2, C10.2, C11.2, C12.1, C13.2, C14.2, C15.2, C16.1, C17.2, C18.2, H1.1, H2.1, H3.1, J1.4, J2.4, J3.4, J4.4, J5.4, J6.3 (GND), J6.5 (GND), J6.9 (GNDDetect), J7.4, J8.3, J9.3, J10.3, J11.3, J12.3, J13.3, J14.3, J15.3, J16.3, J17.3, J18.3, J19.3, J20.3, J21.3, J22.3, J23.3, J24.3, J25.3, J27.5, Q1.3 (S), Q2.3 (S), Q3.3 (S), Q4.3 (S), Q5.3 (S), Q6.3 (S), R6.2, R7.2, R8.2, R13.2, R14.2, R21.1, R23.2, R24.2, SW1.1, U1.10 (GND), U2.5 (VSS/VSSA), U3.2 (GND), U4.2 (GND), Y1.2, Y1.4
unnamed: C16.2, R15.1, Y1.1
unnamed: D1.2 (A), R1.2
unnamed: D1.1 (K), Q1.1 (D)
unnamed: D2.2 (A), R2.2
unnamed: D2.1 (K), Q2.1 (D)
unnamed: D3.2 (A), R9.2
unnamed: D3.1 (K), Q3.1 (D)
unnamed: D4.2 (A), R10.2
unnamed: D4.1 (K), Q4.1 (D)
unnamed: D5.2 (A), R16.2
unnamed: D5.1 (K), Q5.1 (D)
unnamed: D6.2 (A), R17.2
unnamed: D6.1 (K), Q6.1 (D)
unnamed: J9.2, J10.2, J15.2, J16.2, J21.2, J22.2
unnamed: J11.2, J12.2, J17.2, J18.2, J23.2, J24.2
unnamed: J13.2, J19.2, J25.2, R25.1
unnamed: J8.2, J14.2, J20.2, R18.2
unnamed: Q1.2 (G), R4.1, R7.1
unnamed: Q2.2 (G), R5.1, R8.1
unnamed: Q3.2 (G), R11.1, R13.1
unnamed: Q4.2 (G), R12.1, R14.1
unnamed: Q5.2 (G), R19.1, R23.1
unnamed: Q6.2 (G), R20.1, R24.1
unnamed: R3.2, R6.1, U1.9 (FB)
unnamed: C7.1, U1.8 (VCC), U1.11 (RT)
unnamed: U1.5 (SW), U1.6 (SW)
unnamed: R18.1, U4.8 (B1)
unnamed: R25.2, U4.1 (B2)
VDD: C1.1, C2.1, C3.1, C8.1, C11.1, J1.1, J2.1, J3.1, J4.1, J5.1, J7.1, U1.2 (EN), U1.3 (VIN)

Notes on the sheet:
UART_2_LEDs
+5V to +3V3 Converter
+5V Bulk Converter
Optionnal
SWD Connector
LEDS DISPLAY
UART_1_LEDs
UART_3_LEDs
MCU Reset
UARTs
MCU Ext Clock (Optionnal)
MCU Regulation
Mounting Holes

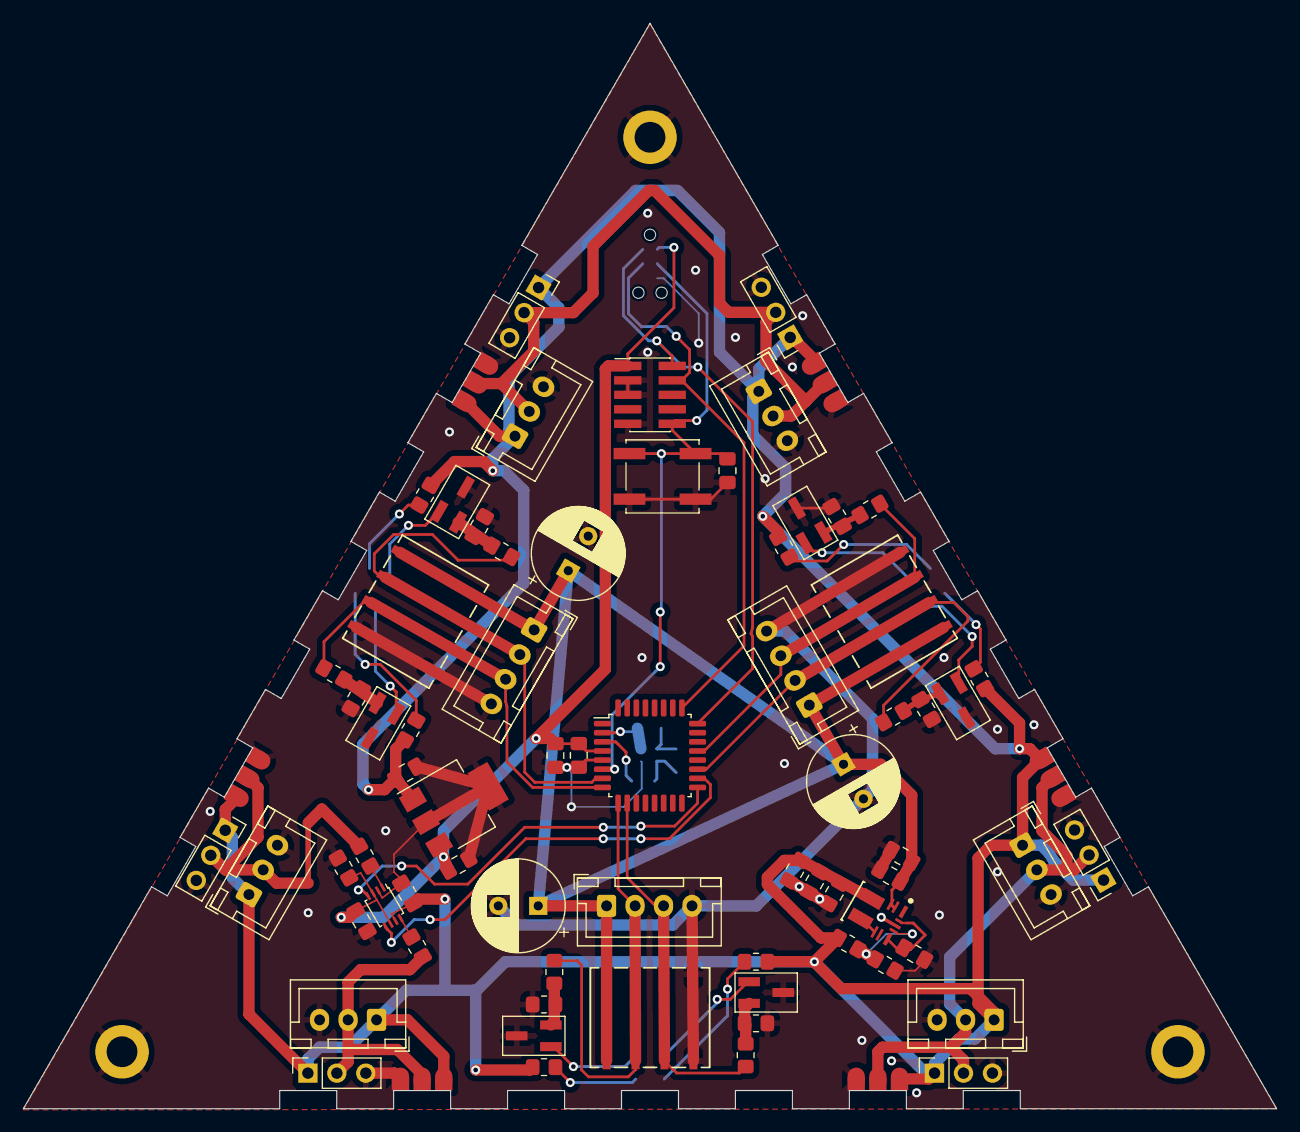
[picture p22: board Small.kicad_pcb from above]

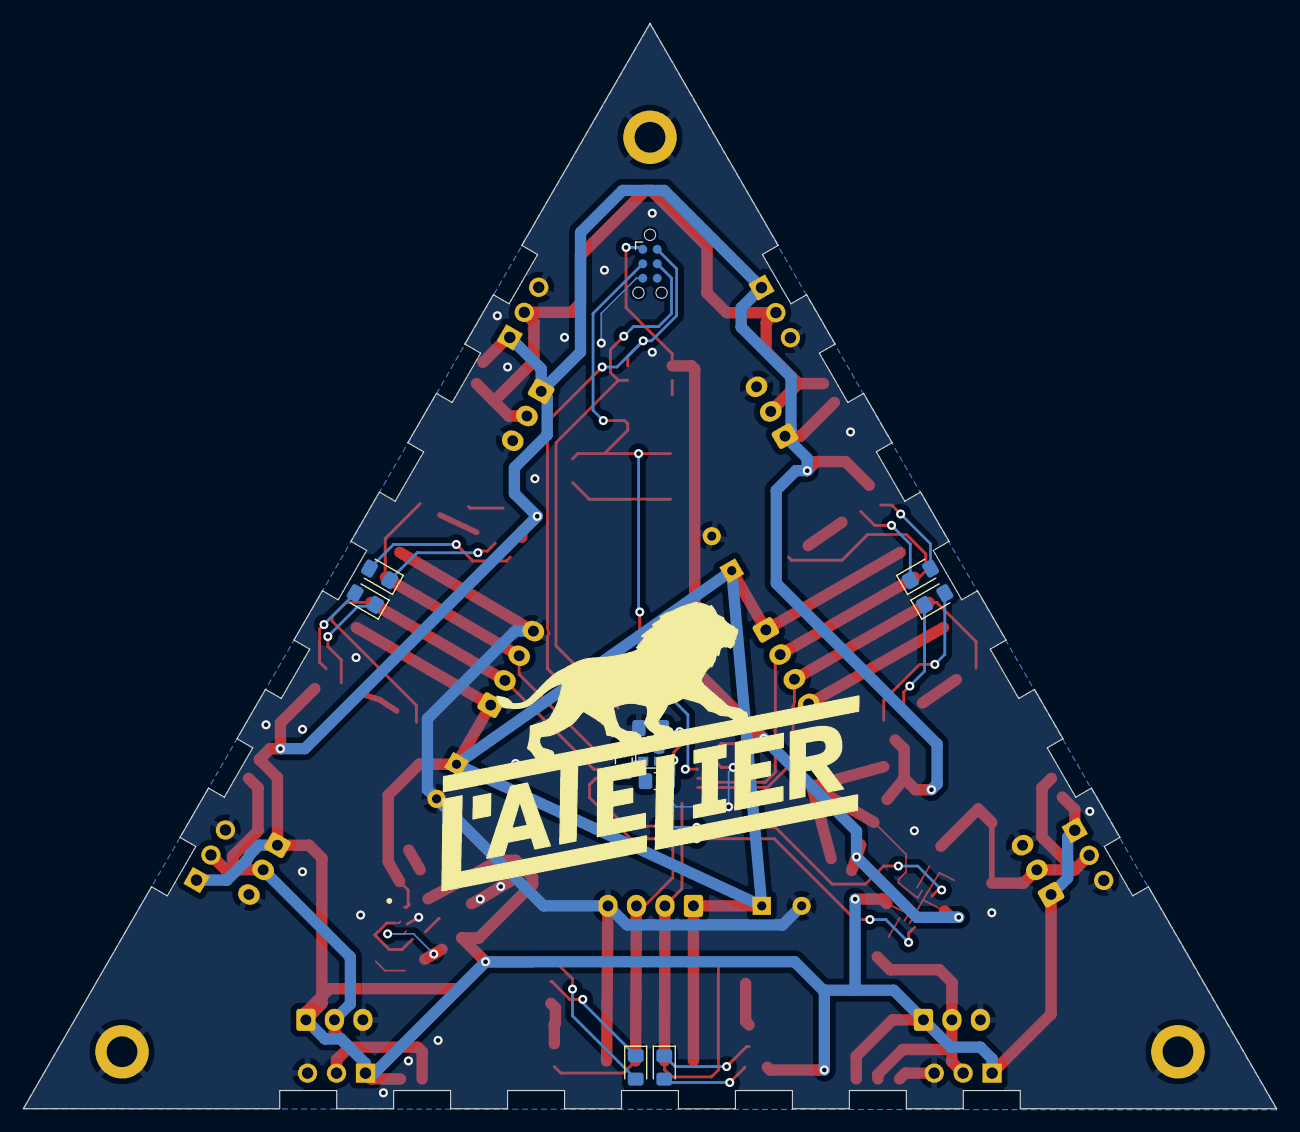
[picture p23: board Small.kicad_pcb from below]

Board: 2 copper layers, 110.0 x 95.3 mm, 89 parts (11 on the bottom side), 45 nets.
