atelier-lyon/Epiled_slaves/Middle_Wall/Middle_Wall.kicad_pcb

## KiCad design Middle_Wall/Middle_Wall.kicad_pcb (2023-07-17)

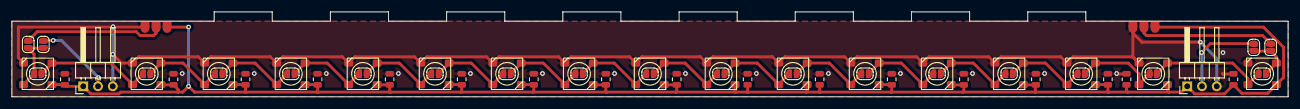
[picture p24: board Middle_Wall.kicad_pcb from above]

Board: 2 copper layers, 219.6 x 14.6 mm, 59 parts (0 on the bottom side), 24 nets.

Parts:
C1, C2, C3, C4, C5, C6, C7, C8, C9, C10, C11, C12, C13, C14, C15, C17, C18: 100nF; C_0805_2012Metric
J1: Conn_01x03; PinHeader_1x03_P2.54mm_Horizontal
J2, J4: Conn_01x03; SolderWirePad_1x03_Corner_SMD
JP1, JP2, JP3, JP4, JP5, JP6, JP7, JP8, JP9, JP10, JP11, JP12, JP13, JP14, JP15, JP16, JP17, JP18, JP19, JP21, JP22: SolderJumper_2_Open; SolderJumper-2_P1.3mm_Open_RoundedPad1.0x1.5mm
U1, U2, U3, U4, U5, U6, U7, U8, U9, U10, U11, U12, U13, U14, U15, U17, U18: IN-PI55TATPRPGPB
locked: locked; PinHeader_1x03_P2.54mm_Horizontal

Connections:
GND: C1.2, C2.2, C3.2, C4.2, C5.2, C6.2, C7.2, C8.2, C9.2, C10.2, C11.2, C12.2, C13.2, C14.2, C15.2, C17.2, C18.2, J1.3, J2.1, J4.1, U1.3 (VSS), U2.3 (VSS), U3.3 (VSS), U4.3 (VSS), U5.3 (VSS), U6.3 (VSS), U7.3 (VSS), U8.3 (VSS), U9.3 (VSS), U10.3 (VSS), U11.3 (VSS), U12.3 (VSS), U13.3 (VSS), U14.3 (VSS), U15.3 (VSS), U17.3 (VSS), U18.3 (VSS), locked.3
unnamed: J1.2, JP1.1 (A)
unnamed: J2.2, JP2.1 (A)
unnamed: JP10.1 (A), locked.2
unnamed: J4.2, JP11.1 (A)
unnamed: JP1.2 (B), JP2.2 (B), JP3.1 (A), U1.4 (DIN)
unnamed: JP3.2 (B), JP4.1 (A), U1.2 (DOUT), U2.4 (DIN)
unnamed: JP4.2 (B), JP5.1 (A), U2.2 (DOUT), U3.4 (DIN)
unnamed: JP5.2 (B), JP6.1 (A), U3.2 (DOUT), U4.4 (DIN)
unnamed: JP6.2 (B), JP7.1 (A), U4.2 (DOUT), U5.4 (DIN)
unnamed: JP7.2 (B), JP8.1 (A), U5.2 (DOUT), U6.4 (DIN)
unnamed: JP8.2 (B), JP9.1 (A), U6.2 (DOUT), U7.4 (DIN)
unnamed: JP10.2 (B), JP11.2 (B), JP18.2 (B), U14.2 (DOUT)
unnamed: JP12.1 (A), JP22.2 (B), U8.4 (DIN), U18.2 (DOUT)
unnamed: JP12.2 (B), JP13.1 (A), U8.2 (DOUT), U9.4 (DIN)
unnamed: JP13.2 (B), JP14.1 (A), U9.2 (DOUT), U10.4 (DIN)
unnamed: JP14.2 (B), JP15.1 (A), U10.2 (DOUT), U11.4 (DIN)
unnamed: JP15.2 (B), JP16.1 (A), U11.2 (DOUT), U12.4 (DIN)
unnamed: JP16.2 (B), JP17.1 (A), U12.2 (DOUT), U13.4 (DIN)
unnamed: JP17.2 (B), JP18.1 (A), U13.2 (DOUT), U14.4 (DIN)
unnamed: JP9.2 (B), JP19.1 (A), U7.2 (DOUT), U15.4 (DIN)
unnamed: JP19.2 (B), JP21.1 (A), U15.2 (DOUT), U17.4 (DIN)
unnamed: JP21.2 (B), JP22.1 (A), U17.2 (DOUT), U18.4 (DIN)
VDD: C1.1, C2.1, C3.1, C4.1, C5.1, C6.1, C7.1, C8.1, C9.1, C10.1, C11.1, C12.1, C13.1, C14.1, C15.1, C17.1, C18.1, J1.1, J2.3, J4.3, U1.1 (VDD), U2.1 (VDD), U3.1 (VDD), U4.1 (VDD), U5.1 (VDD), U6.1 (VDD), U7.1 (VDD), U8.1 (VDD), U9.1 (VDD), U10.1 (VDD), U11.1 (VDD), U12.1 (VDD), U13.1 (VDD), U14.1 (VDD), U15.1 (VDD), U17.1 (VDD), U18.1 (VDD), locked.1
