atelier-lyon/Epiled_slaves/(commit log)

2023-06-23 [MID] Add inital schematic
    [NanoLeaf_Slave.kicad_pcb, NanoLeaf_Slave.kicad_sch]
2023-06-26 [SMA] Add inital schematic
    [Small.kicad_pcb, Small.kicad_sch]
2023-07-04 [SMA] Improve schematic
    [Small.kicad_sch]
2023-07-11 [SMA] Edit schematic + Add footprints + begin PCB
    [Small.kicad_pcb, Small.kicad_sch]
2023-07-12 [SMA] Improve PCB
    [Small.kicad_pcb, Small.kicad_sch]
2023-07-12 [SMA] Finish PCB
    [Small.kicad_pcb, Small.kicad_sch]
2023-07-14 [SMA][WALL] Add Finished Wall
    [Small_Wall.kicad_pcb, Small_Wall.kicad_sch]
2023-07-15 [SMA][GER] Add Small Gerber v1.0
    [Small-B_Cu.gbr, Small-B_Mask.gbr, Small-B_Paste.gbr, Small-B_Silkscreen.gbr, Small-Edge_Cuts.gbr, Small-F_Cu.gbr, Small-F_Mask.gbr, Small-F_Paste.gbr]
2023-07-17 WIP middle
    [NanoLeaf_Slave.kicad_pcb, NanoLeaf_Slave.kicad_sch]
2023-07-17 MiddleSize Nanoleaf Finished
    [Middle.kicad_pcb, Middle.kicad_sch]
2023-07-17 Middle_Wall finished, fix on MiddleNanoleaf
    [Middle.kicad_pcb, Middle_Wall.kicad_pcb, Middle_Wall.kicad_sch]
2023-07-18 [SMA][WALL][GER] Add Small Gerber v1.0
    [Small_Wall-B_Cu.gbr, Small_Wall-B_Paste.gbr, Small_Wall-B_Silkscreen.gbr, Small_Wall-Edge_Cuts.gbr, Small_Wall-F_Cu.gbr, Small_Wall-F_Paste.gbr, Small_Wall-F_Silkscreen.gbr, Small_Wall-NPTH.drl]
2023-07-18 [SMA][WALL][VIEW] Add missing step
    [small_wall_v1.0.step]
2023-11-13 [SMA] Fix many bug
    [Small.kicad_pcb, Small.kicad_sch]
2023-11-13 [MID][WALL] Change files path
    [Middle_Wall.kicad_pcb, Middle_Wall.kicad_sch]
2023-11-13 [SMA][WALL] Update wall
    [Small_Wall.kicad_pcb, Small_Wall.kicad_sch]
2023-11-13 [SMA][GER] Update Gerber files
    [Small-B_Cu.gbr, Small-B_Mask.gbr, Small-B_Paste.gbr, Small-B_Silkscreen.gbr, Small-Edge_Cuts.gbr, Small-F_Cu.gbr, Small-F_Mask.gbr, Small-F_Paste.gbr]
2023-11-13 [SMA] Update PCB
    [Small.kicad_pcb]
2023-11-13 [SMA][DXF] Add DXF folder
    [Small-B_Silkscreen.dxf, Small-F_Silkscreen.dxf]
2023-11-13 [SMA][WALL][GER] Update Gerber
    [Small_Wall-B_Cu.gbr, Small_Wall-B_Mask.gbr, Small_Wall-B_Silkscreen.gbr, Small_Wall-Edge_Cuts.gbr, Small_Wall-F_Cu.gbr, Small_Wall-F_Mask.gbr, Small_Wall-F_Paste.gbr, Small_Wall-F_Silkscreen.gbr]
2023-11-13 [SMA][WALL][DXF] Add DXF folder
    [Small_Wall-B_Silkscreen.dxf, Small_Wall-F_Silkscreen.dxf]
